1wf3/esp32-s3/output/navigation-concepts/04-全长方屏配色与设备管理.png

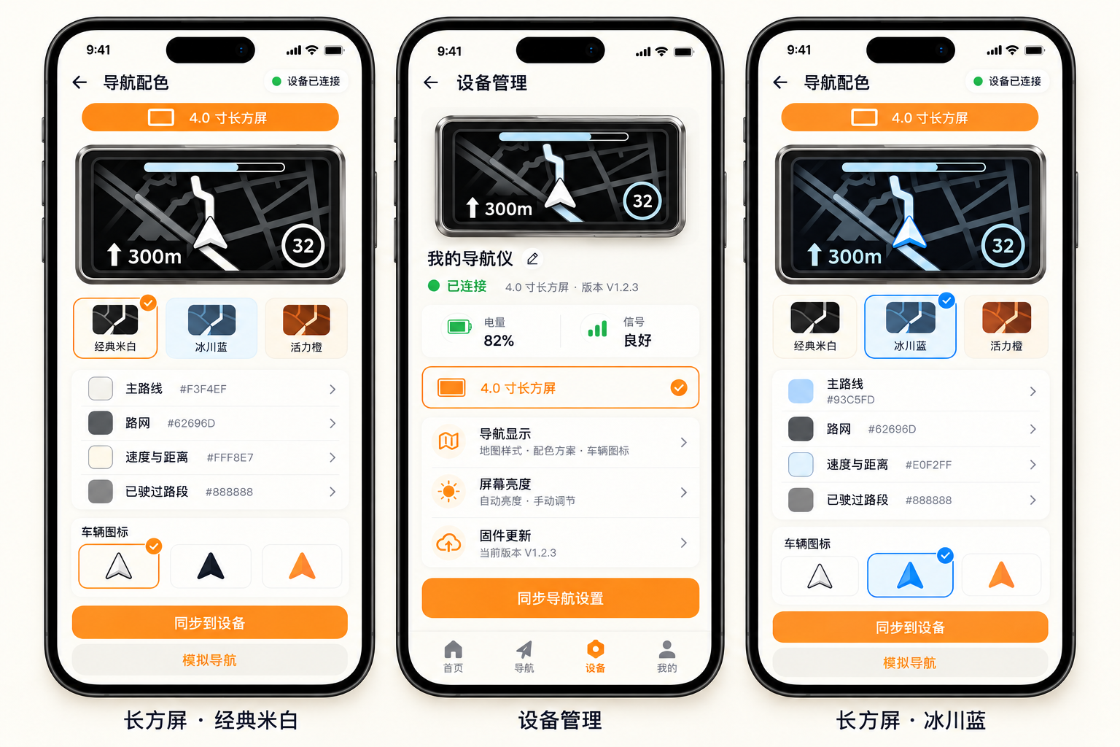
output/navigation-concepts/04-全长方屏配色与设备管理.png
