1wf3/esp32-s3/output/navigation-concepts/05-开机动画概念分镜.png

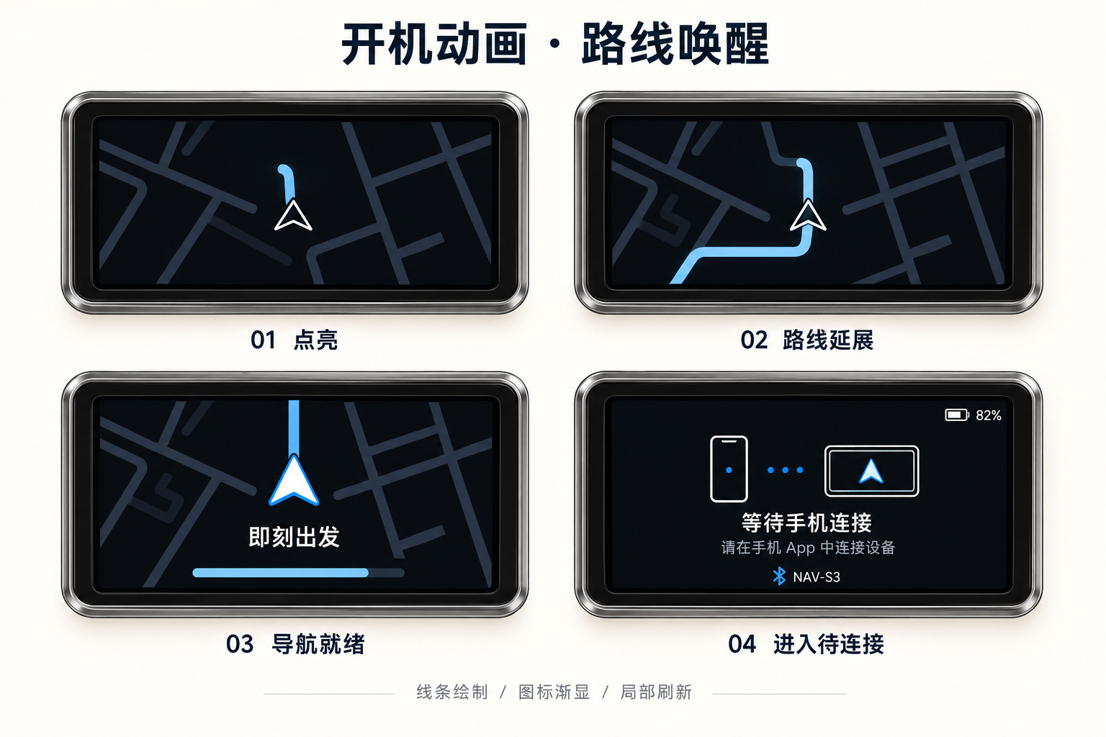
output/navigation-concepts/05-开机动画概念分镜.png
