1wf3/esp32-s3/output/carrier_v01/PCB全部连接表_当前J1J4位号.md

# PCB 全部连接表（当前位号，2026-10-20）

本表依据实物照片转录的排针顺序、用户当前原理图及 phone_ble_nav 固件整理。它是布线目标，不表示用户 PCB 已完成连通性或机械验收。

## 位号与方向

- 顶面视图：天线在上、USB 在下，两排 1 脚均在上。
- J1：左排 1×22 排母，原称 J1A。
- J4：右排 1×22 排母，原称 J1B。
- J2：屏幕 2×5 接口；J3：GPS XH4 接口；JP1：两针电源跳帽。
- 电阻两端以 PCB 焊盘的实际网络名区分，不用画面左右方向判断。移动或旋转元件不会改变焊盘网络。

## 当前采用的布局（2026-10-20 17:46 截图）

用户选择保持此布局：J1 是中部的 22 针排母，J4 是最右侧 22 针排母；J3 在 J1 左上方、J2 在 J1 左下方、JP1 在 J1 左上侧；多数屏幕信号电阻位于 J1 与 J2 之间。
该布局下，先把 GPIO 端焊盘短接到 J1 对应针脚，再把 LCD 端焊盘通过左侧短通道接到 J2。不能沿用更早截图中“某个元件在右侧”的位置描述判断网络。
排母整体已经移动，之前 1 脚坐标 (60,-70)/(1060,-70) 不再可直接套用。两排中心距、1～22针距、实际天线投影及底板开窗/禁铜需按新位置复核；旧板框顶部与天线外伸的结论未验证。

## 信号：每条都分成电阻前后两个网络

| 功能 | 开发板端 | 第一网络 | 电阻 | 第二网络 | 外设端 |
|---|---|---|---|---|---|
| 屏幕时钟 | J1.18 | GPIO12 | R1 33Ω | LCD_SCK | J2.3 |
| 屏幕写数据 | J1.17 | GPIO11 | R2 33Ω | LCD_MOSI | J2.5 |
| 屏幕片选 | J1.16 | GPIO10 | R3 0Ω | LCD_CS | J2.7 |
| 屏幕数据/命令 | J1.15 | GPIO9 | R4 0Ω | LCD_DC | J2.6 |
| 屏幕复位 | J1.20 | GPIO14 | R5 0Ω | LCD_RST | J2.8 |
| 屏幕读数据 | J1.8 | GPIO15 | R6 0Ω | LCD_MISO | J2.10 |
| GPS 向开发板输出数据 | J1.10 | GPIO17 | R8 1kΩ | GPS_TX | J3.3 |

例：J1.18 与 R1 的 GPIO12 焊盘同网；R1 另一焊盘与 J2.3 同属 LCD_SCK。不要用导线跨过电阻把两个网络短接。

## 电源与背光

1. DEV_3V3：J1.1、J1.2、JP1.1 全部相连。
2. 3V3_PERIPH：JP1.2、J2.2、J3.1、R7 的 3V3_PERIPH 焊盘、C1～C6 的电源端全部相连。
3. LCD_LED：R7 的 LCD_LED 焊盘接 J2.9。R7=0Ω，仅作连接/隔离，不是裸 LED 的限流电阻。
4. JP1 使用插拔跳帽接通两针。PCB 上不应另用铜线绕过 JP1 连接 DEV_3V3 和 3V3_PERIPH。
5. USB 电源仍从现有开发板 USB 进入。J1.21（5V）不接，不接车辆高压电源。

## 公共地

以下全部属于 GND：

- J1.22。
- J4.1、J4.21、J4.22。
- J2.1、J2.4。
- J3.2。
- C1、C2、C3、C4、C5、C6 的接地端。

建议保持底层 GND 尽量连续。顶层贴片电容的地焊盘可用附近接地过孔连接到底层 GND。布铜后检查孤岛和实际连接，不能仅凭可见铜皮认为所有地已接通。

## 六颗电容

全部是无极性陶瓷电容，一端接 3V3_PERIPH，另一端接 GND，按导入的焊盘网络连接。

| 位置 | 10µF | 100nF |
|---|---|---|
| JP1 外设供电侧 | C1 | C4 |
| 屏幕 J2 电源侧 | C2 | C5 |
| GPS J3 电源侧 | C3 | C6 |

## 留空针脚

- J1：3、4、5、6、7、9、11、12、13、14、19、21。
- J4：2～20。
- J3：4。GPS 的 RX/PPS 不接。
- 安装孔无电气网络，孔周围安装禁布区不走线、放铜或放器件。

## 按顺序布线

1. 缩短 R1 输出的 LCD_SCK 走线。当前沿板底绕行的线路建议改成穿过排母相邻焊盘间隙的短路径，以规则允许的通道为准。不要接触其他焊盘，也不要降低安全间距强行通过。
2. 布 R2/MOSI，再布 CS、DC、RST、MISO 和 GPS。
3. 布电源与背光支路，再完成地连接与 GND 铺铜。
4. 信号线默认 10mil；电源主干初始采用 32mil。靠近小焊盘时按间距规则适当收窄，不能挤到旁边焊盘。
5. 优先顶层短信号线，保留底层连续地。若通道实在不足，可从顶层 SMD 焊盘短引出后用金属化过孔换到底层；J2/J1/J4 的通孔焊盘可从底层连接。只在屏幕上切换图层不会产生电气连接。
6. 每根线从正确网络的焊盘开始，到同网络目标焊盘结束。蓝色飞线是连通提示，不是必须照着走的物理路径。
7. 最终运行 PCB 的设计→检查DRC；区分原理图DRC结果。检查未连接、短路、间距、板边、安装禁布区，并在铺铜后再次核对。

## 接外设线束

J2/J3 是本底板定义的针序，连接现有屏幕和 GPS 模块时必须按各自实物丝印逐信号对应，不假设原模块针序与底板相同。

仍待核对：排母实际孔径/高度/插接、首次至末次针距、USB 插头空间、GPS/屏幕线束和总电流。未完成实际投板或硬件验收。
