1wf3/esp32-s3/output/carrier_v01/嘉立创绘制说明.md

# 导航转接底板 V0.1：嘉立创 EDA 绘制说明

设计日期：2026-10-19。用户选择保留现有开发板，制作插接底板。已生成电气原理图与位置示意，尚无实际 EDA 工程、ERC/DRC 或可生产 Gerber。开发板排针封装、屏幕原插座顺序与安装孔距需要实测，不能按图中比例猜。

## 一、设计选择

充电宝 → 开发板原 USB 口 → 开发板原稳压器 → DEV_3V3 → JP1 → +3V3_PERIPH。保持与现有面包板一致的 3.3 V 供电及 GPIO 分配。底板不新增 USB、电源芯片、车载电源、锂电充电、电量、鸣笛或亮度电路。GPS 沿用现成 ATGM336H 板及原天线，底板不做射频线路。

JP1 是两针短路帽，只隔离屏幕/GPS外设电源。拔下 JP1 不会关闭开发板；要完全关机需断开 USB。不要给 TP1/TP2 或外设网络同时灌入第二路电源。R7 为 0Ω 跳线，不承担背光恒流/限流，限于目前已点亮的现成屏幕背板输入。

屏幕使用已验证的 ILI9488 兼容初始化，这不等于已确定液晶驱动芯片型号。当前固件 40 MHz SPI；外设逻辑和电源均为 3.3 V。GPIO12=SCK、11=SDI、10=CS、9=D/C、14=RESET、15=SDO；GPS TX→R8→GPIO17，GPS RX/PPS 不接。触摸 GPIO4/5/6/7 仅预留，当前固件不启用。

## 二、在嘉立创 EDA 画原理图

1. 先建 J1A/J1B 两条开发板排母：实测 N（每排针数）、P（针间距）、D（两排中心距）后，按元件面实际顺序逐脚编号。图中 U1 为功能表示，不能把 GPIO 编号直接当排母焊盘编号，也不能套官方 DevKitC-1 封装假定兼容。
2. 复制“接口逐针网络表.csv”中的网络标签；ESP32 端 GPIO 名与实物的排针脚号需要你逐项对应。每一颗串联电阻两侧是不同网络，不能把两端用同一标签短接。
3. J2 用防呆 2×5/2.54 mm 简牛，符号脚号与所选 PCB 焊盘对应。针序是本底板定义，不是现有屏幕的原排针序。排线另一端按屏幕丝印配线；若要直接插屏幕，需额外按原接口实测制作小转接头。
4. J3 用 XH-4/2.50 mm，1=3.3 V、2=GND、3=GPS TX、4=NC。此针序同样为底板定义，GPS 原模块接口不一定相同。J3-4 加未连接标记，线束对应孔留空。
5. 串联电阻：R1/R2=33Ω；R3/R4/R5/R6/R7=0Ω；R8=1kΩ。先按图安装，R1/R2可备22Ω/0Ω用于波形或兼容性调试；阻值不是所有线长下的保证。
6. C1/C3/C5=10µF，C2/C4/C6=100nF，分别跨接 +3V3_PERIPH 与 GND。C1/C2靠JP1，C3/C4靠J2，C5/C6靠J3。0805仅是本方案建议封装；10µF/≥10V/X7R需要核对直流偏压后的有效电容。
7. J4 为可选 XH-6：1=3.3V、2=GND、3=GPIO4/SDA、4=GPIO5/SCL、5=GPIO6/INT、6=GPIO7/RST。R9/R10为4.7k上拉，分别从GPIO4/5到3.3V，C7为J4供电去耦。J4、R9/R10、C7默认不装；模块已有上拉时不重复装。
8. 测试点：TP1=DEV_3V3，TP2=+3V3_PERIPH，TP3=GND，TP4=GPIO17（R8的ESP32侧）。不用的开发板引脚标NC；5V/VIN、EN/BOOT、USB19/20等保持原开发板电路，不另外并接。
9. ERC后再转PCB。若输入电源被ERC认为未驱动，使用工具相应的电源标识表达“由开发板输出”，不要为消除报错把不同电源网短接。

## 三、底板封装和布线

机械待测表：

| 项目 | 数值 | 怎么测 |
|---|---|---|
| 每排针数 N | 待测 | 左右分别计数，不假定20/22脚 |
| 排针脚间距 P | 待测 | 测多脚中心距离除以间隔数，避免单格误差 |
| 两排中心距 D | 待测 | 从同一端对应排针中心量到另一排中心 |
| 屏幕原接口针序/间距 | 待测 | 正反面丝印照片+厂家尺寸图+万用表 |
| 屏幕/开发板尺寸与安装孔距 | 待测 | 卡尺，注明元件面与孔中心 |
| 排母高度/USB空间 | 待测 | 检查开发板背面元件不顶到底板 |
| LDO型号及额定/热能力 | 待测 | 板上器件丝印、实际板资料、负载测量 |

建议2层FR-4/1.6mm/1oz；本方案不是ESP32裸模块重设计。信号起步0.25mm、间距0.25mm，3.3V主干起步0.8mm，按负载和可制造性复核。底层尽量完整GND，不在SPI下方跨地分割。R1/R2尽量靠ESP32源端，R6靠SDO输出端J2。PCB上MCU到J2目标≤30mm，排线尽量≤50mm；这些是布线目标，不是40MHz必定稳定的承诺。

ESP32天线端优先伸出底板边缘；天线下方不要铺铜、走线、放金属或电池，净空按对应模块手册。GPS原天线朝天，远离时钟线和屏幕；保留原射频线，不随意换有源/无源天线。底板边框、孔距随实物与外壳确定，本图不给未经测量的80×60等尺寸。四个M3孔可先按Ø3.2mm非金属化孔考虑，但孔距、螺母净空和螺柱高度都要复核。打印1:1纸样套实物后再下单。

## 四、电源预算是定版条件

这是无源连接底板，外设电流全部经过现有开发板LDO。应核对 I_LDO总=I_ESP32板+I_LCD含背光+I_GPS+I_可选触摸，并用实际板电路确认额定、热余量与启动瞬态。不能从“USB 5V 1A”推导3.3V端也能输出1A。

先保持现有供电路径：USB只接开发板，外设只接3.3V。如果LDO过热、3.3V跌落或超出规格，暂不投板，改为独立稳压并进行电源隔离的新版本；不要把额外稳压器直接并到开发板3V3输出。当前没有开发板稳压芯片型号，未虚构其可用输出电流。

焊接前断电；JP1拔下可区分开发板与外设负载。完成线束和电源通断检查后，先只给开发板上电测TP1，再断电插模块、合JP1测TP2。GPS RX/PPS不接，TX只能接GPIO17输入。依次检查显示、蓝牙、NMEA和室外搜星；便携安装应固定线束和模块，避免仅靠排母承重。

## 五、物料清单

完整见“物料清单_BOM.csv”。已有ESP32-S3、屏幕、GPS及天线复用。新购主要为两条排母、J2简牛与短线束、J3 XH-4线束、JP1短路帽、电阻8颗、电容6颗、PCB与安装件。可选触摸件不计入上述8颗电阻/6颗电容。测试点是PCB焊盘，不额外采购。连接器在嘉立创按规格找料，确认针距、脚号、方向、外形与孔径，不按本图选未经匹配的商城编号；没有声明价格或库存。

## 六、来源与状态

- 本地接线：software/phone_ble_nav/phone_ble_nav.ino；GNSS模块接线与测试.md；GNSS首次搜星诊断.md；大屏真实导航使用说明.md。仅采用其中当前仍有效的硬件接线，不沿用历史Wi-Fi独立导航方案。
- Espressif供电参考：https://docs.espressif.com/projects/esp-dev-kits/en/latest/esp32s3/esp32-s3-devkitc-1/user_guide_v1.0.html （官方板参考，不能证明你的克隆板封装或电流能力相同）
- Espressif天线/PCB布局：https://docs.espressif.com/projects/esp-hardware-design-guidelines/en/latest/esp32s3/pcb-layout-design.html （本方案的两层载板建议属于基于指南的工程推导，不等于官方完整设计）
- JST XH 官方规格：https://www.jst.com/wp-content/uploads/2025/06/eXH.pdf （针距2.50 mm；连接器和压接端子需同系列匹配）
- 中科微ATGM336H-5N：https://icofchina.com/daohang/danpin/2525.html （裸模块2.7~3.6V；你的成品转接板供电仍需实物核对）

本设计已在文档层核对接口脚号、BOM位号及固件GPIO；未接入嘉立创EDA，未跑ERC/DRC，未制作或上电测试新PCB。下一步需要开发板、屏幕、GPS正反面清晰照片和上述机械数据，才能冻结排母封装与板框。
