1wf3/esp32-s3/output/carrier_v01/开发板插座接线_按实物照片.md

# 开发板插座接线（2026-10-19 实物照片核对）

依据：IMG_2199.JPG 背面丝印、IMG_2196.JPG 元件面照片。尚未做万用表通断核对。

## 统一方向

元件面（有金属屏蔽罩、按键、USB 接口的一面）朝向自己，天线在上，USB 在下。
左排定义为 J1A，右排为 J1B。两排的 1 脚均在天线端，22 脚均在 USB 端。
背面照片左右相反，不可直接照搬背面照片的左右关系到 PCB 顶层。
这是本转接板对插座的编号约定；PCB 上必须核对所选封装的实际焊盘编号并正确旋转。

## 本次需要连接的引脚

| 插座针号 | 实物丝印 | 网络标签 | 去向 |
|---|---|---|---|
| J1A.1、J1A.2 | 3V3 | DEV_3V3 | JP1.1 |
| J1A.8 | 15 | GPIO15 | R6 MCU 侧 |
| J1A.10 | 17 | GPIO17 | R8 MCU 侧，另一端接 GPS_TX/J3.3 |
| J1A.15 | 9 | GPIO9 | R4 MCU 侧 |
| J1A.16 | 10 | GPIO10 | R3 MCU 侧 |
| J1A.17 | 11 | GPIO11 | R2 MCU 侧 |
| J1A.18 | 12 | GPIO12 | R1 MCU 侧 |
| J1A.20 | 14 | GPIO14 | R5 MCU 侧 |
| J1A.22 | GND | GND | 公共地 |
| J1B.1、J1B.21、J1B.22 | GND | GND | 公共地 |

JP1.2 使用 3V3_PERIPH。不要把 DEV_3V3 改成 3V3_PERIPH，否则会绕过跳帽。
J1A.21 是 5V，本版由开发板 USB 供电，转接板该脚不接。
GPIO17 是信号名称，不是插座第 17 脚；对应关系见表。
未使用的其余插座针脚最后添加非连接标识，不要接地。

## 操作顺序

1. 在 J1A、J1B 附近写明上述正面方向与 1 脚方向，普通文字仅作说明。
2. 从表内每个针脚端点画短导线，用网络标签工具放上完全相同的标签。普通文字不产生电气连接。
3. 先接 DEV_3V3 与 GND，再接 GPIO 信号。
4. R8 为 1kΩ：GPIO17—R8—GPS_TX—J3.3；J3.4 放非连接标识。
5. 在网络列表核对同名网络包含相应插座、JP1、电容与连接器端点；检查没有把电阻两端用相同标签短接。
6. 完成原理图检查后再转 PCB；两排插针中心距 D 已于 2026-10-20 根据用户提供数值与 IMG_2206.JPG 尺寸图确认为 25.40mm（1000mil）。这不是板宽或塑料座外沿间距。

## 已补充的机械尺寸（2026-10-20）

- 每排 22 针，相邻针距 2.54mm。
- 两排焊盘中心线间距 25.40mm。
- 同排第 1 针至第 22 针中心距离：21 × 2.54 = 53.34mm。
- 用户尺寸图中的开发板宽度为 27.94mm，不含天线突出部分的板体长度为 57.15mm；这些不是转接底板外形尺寸。
- 数据来自用户数值与所附尺寸图，未独立实测。底板的元件封装、焊盘孔径、实际插接方向、USB 插头空间与天线避让仍需核对。
- 定位以焊盘中心为准。元件属性中的 X/Y 是封装原点，只有两个封装的原点和旋转一致时，元件 X 坐标差才可直接作为排距。

当前电容编号按用户原理图：C1/C2/C3 = 10µF；C4/C5/C6 = 100nF。
三组对应电源入口 C1+C4、屏幕 C2+C5、GPS C3+C6；六颗均跨接 3V3_PERIPH 与 GND。
旧版资料包中电容位号安排不同，以此说明和当前 EDA 图为准。

机械尺寸、排母封装焊盘方向、电源负载与 ERC/DRC 尚未完成核验，当前不可直接投板。
