1wf3/esp32-s3/output/carrier_v01/主原理图预览.png

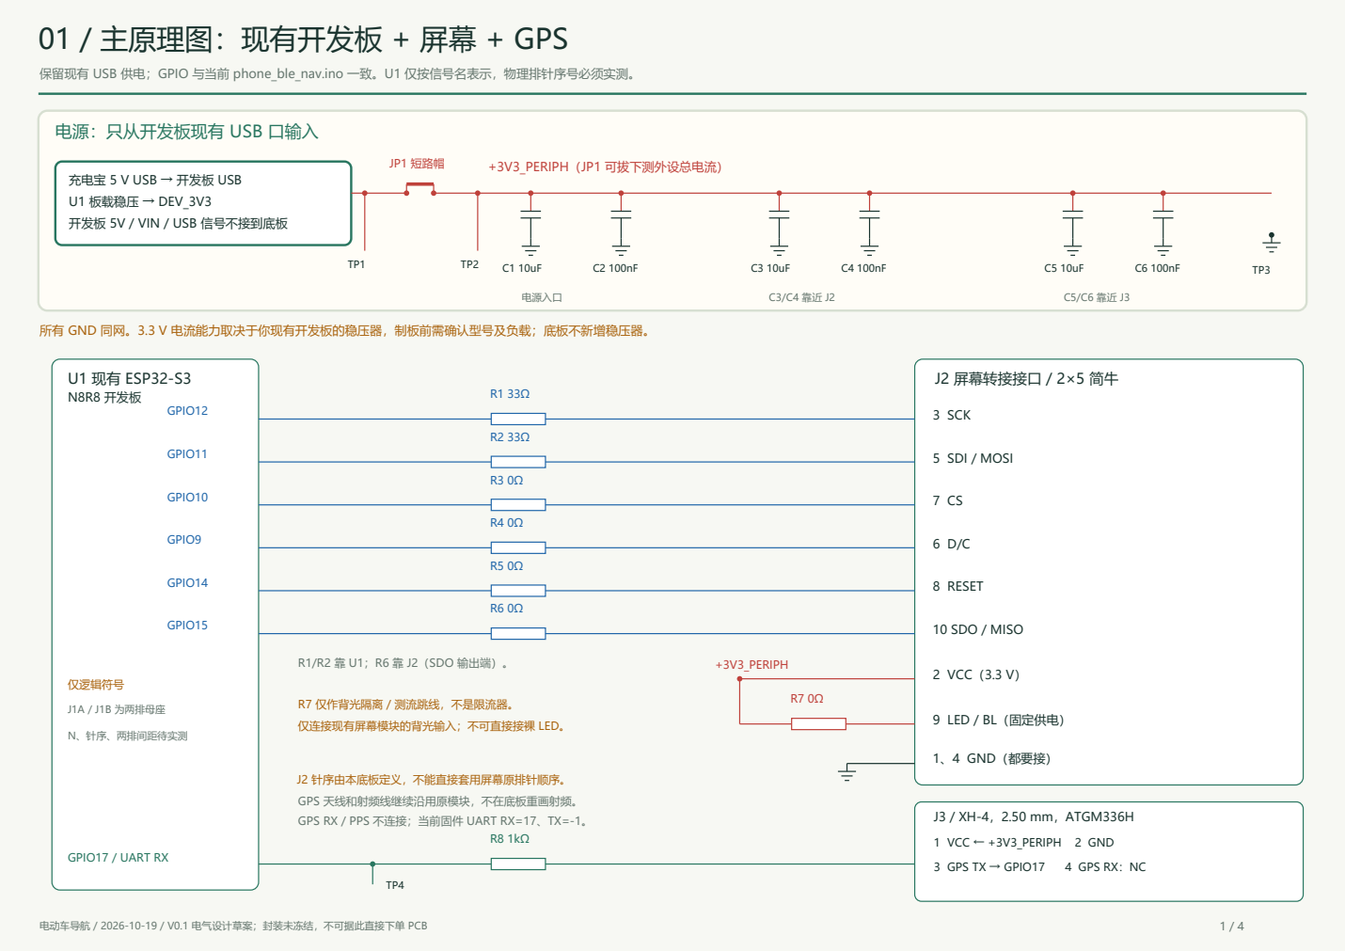
output/carrier_v01/主原理图预览.png
