1wf3/esp32-s3/output/carrier_v01/图纸预览_02.png

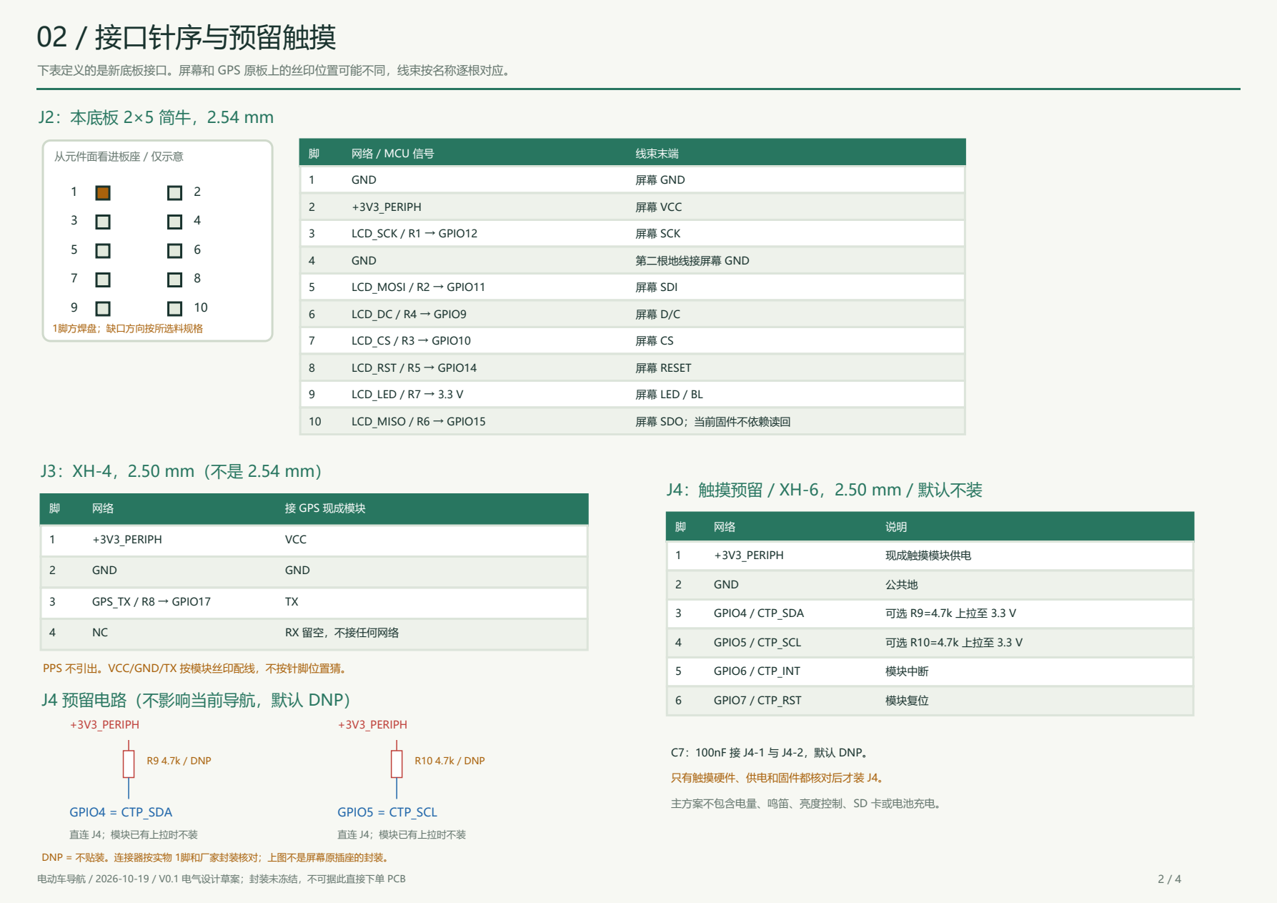
output/carrier_v01/图纸预览_02.png
