1wf3/esp32-s3/output/carrier_v01/背面引脚核对.png

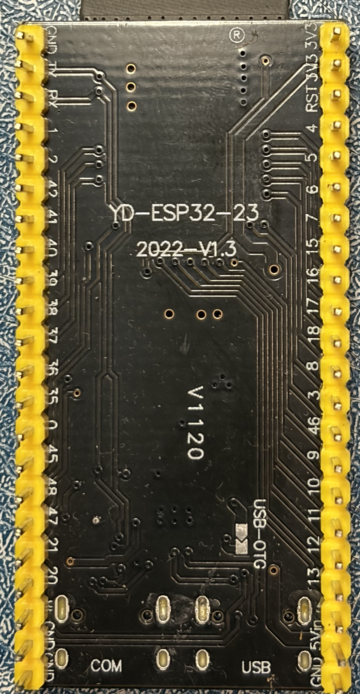
output/carrier_v01/背面引脚核对.png
