1wf3/esp32-s3/output/navigation-concepts/01-手机定位与导航.png

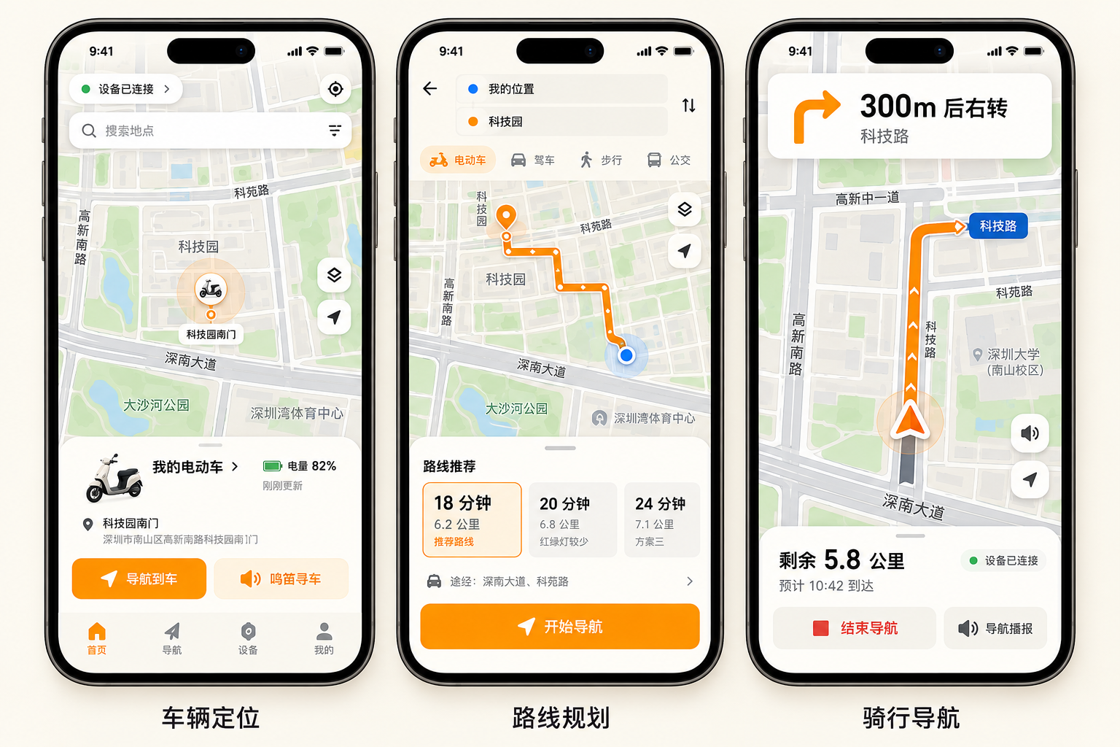
output/navigation-concepts/01-手机定位与导航.png
