1wf3/esp32-s3/output/navigation-concepts/02-配色与设备管理.png

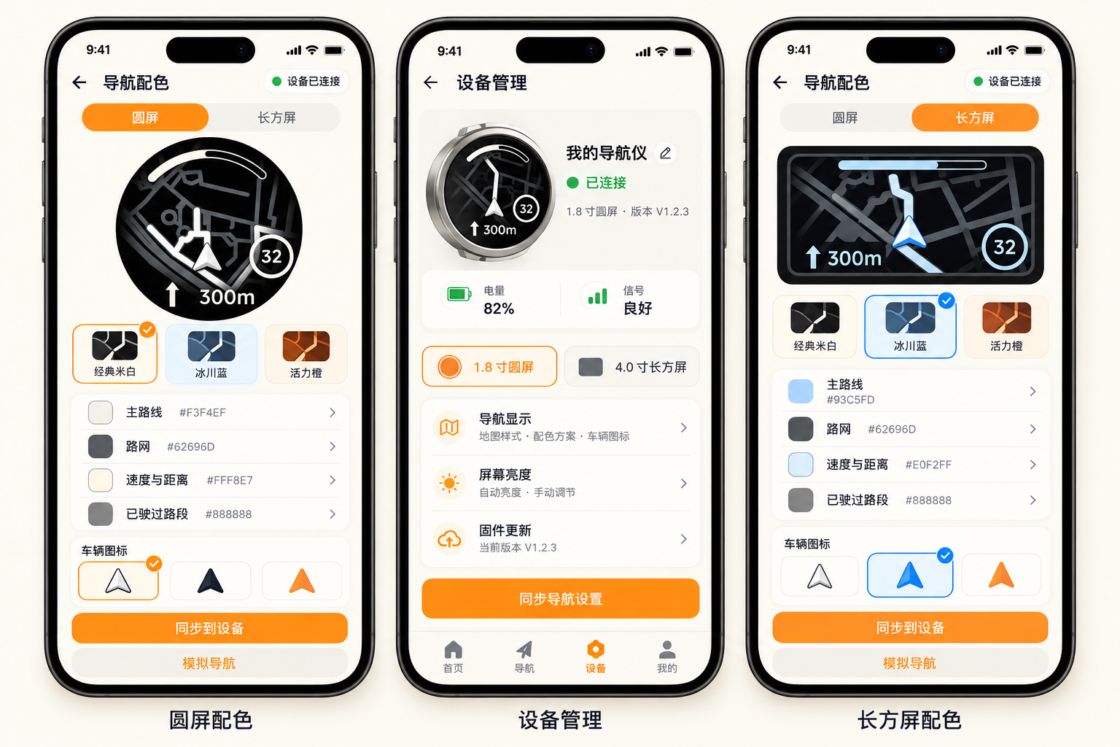
output/navigation-concepts/02-配色与设备管理.png
