1wf3/esp32-s3/output/navigation-concepts/03-圆屏与长方屏导航状态.png

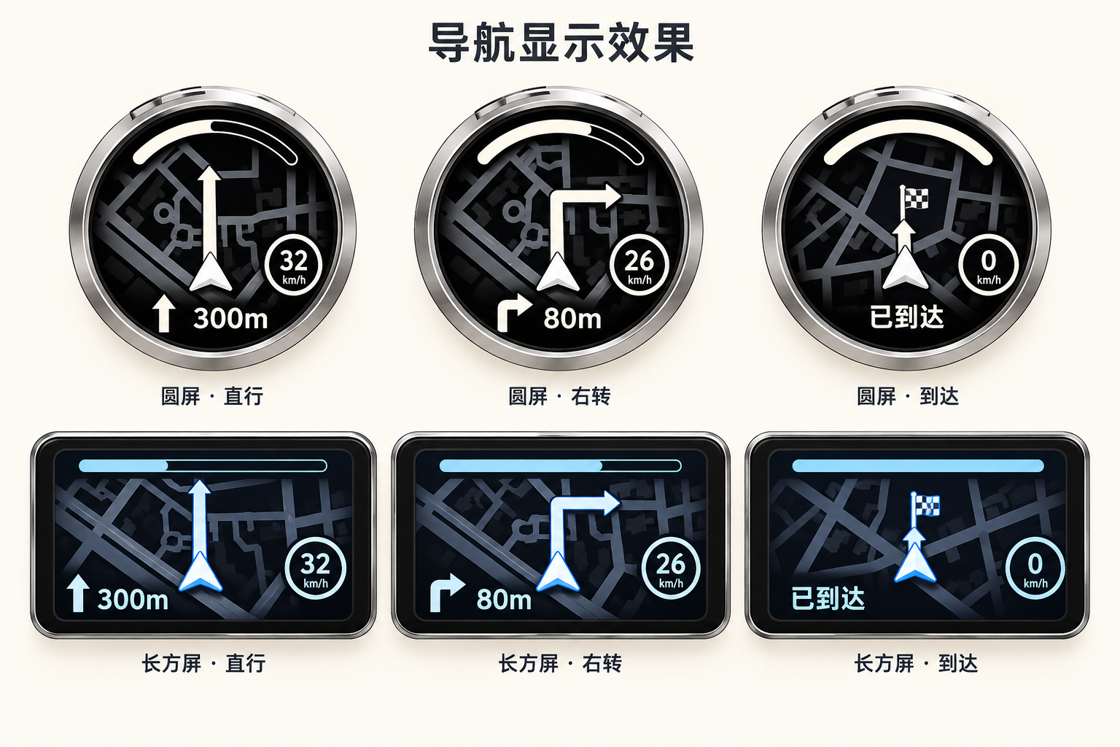
output/navigation-concepts/03-圆屏与长方屏导航状态.png
