1wf3/esp32-s3/output/navigation-concepts/06-等待手机连接.png

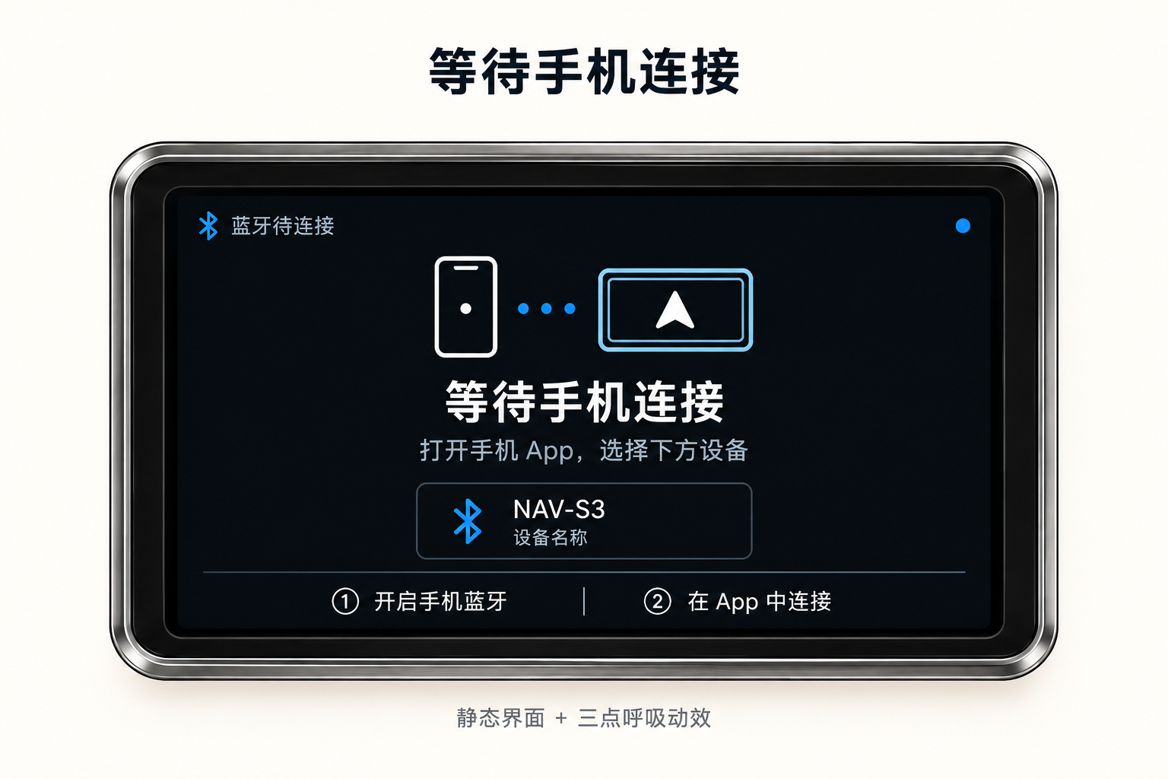
output/navigation-concepts/06-等待手机连接.png
