1wf3/esp32-s3/output/previews/map-scale-20261101/before.png

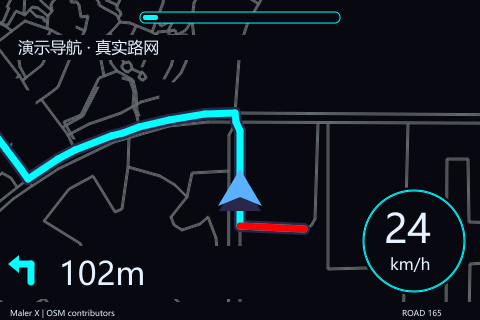
output/previews/map-scale-20261101/before.png
