1wf3/esp32-s3/output/previews/导航屏真实路网效果预览.png

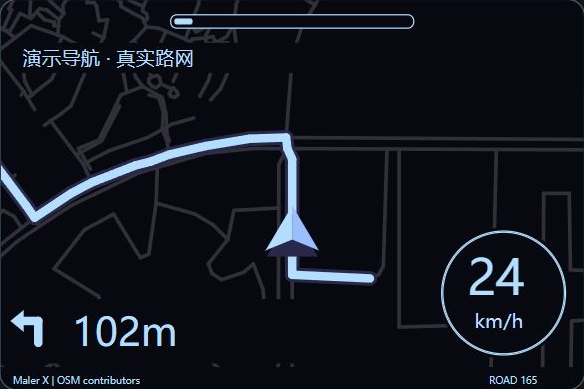
output/previews/导航屏真实路网效果预览.png
