1wf3/esp32-s3/output/previews/开机与手机连接预览.png

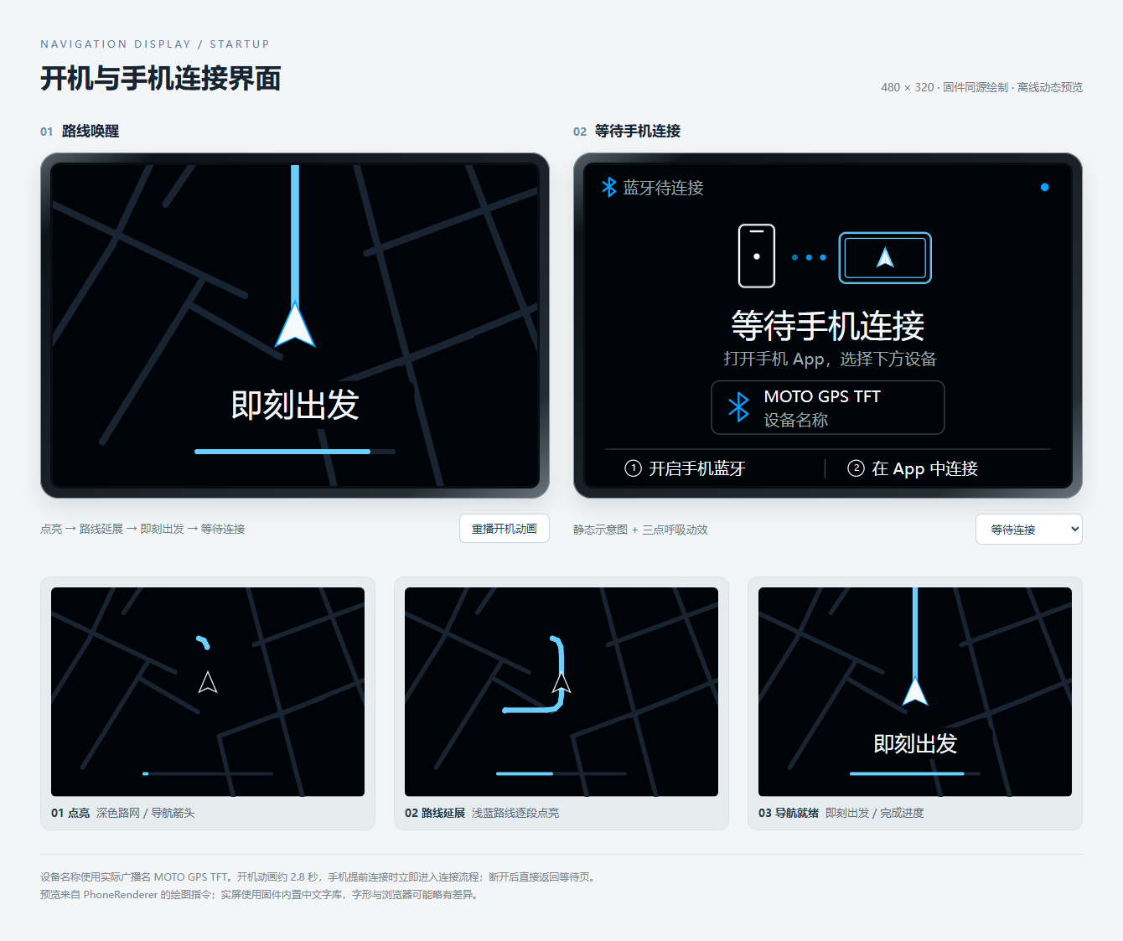
output/previews/开机与手机连接预览.png
