1wf3/esp32-s3/output/previews/开机与等待连接动画.gif

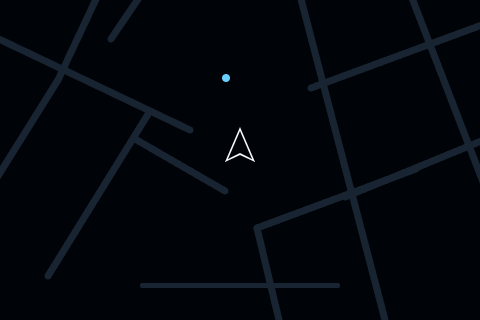
output/previews/开机与等待连接动画.gif
