1wf3/esp32-s3/output/previews/手机应用新版配色.png

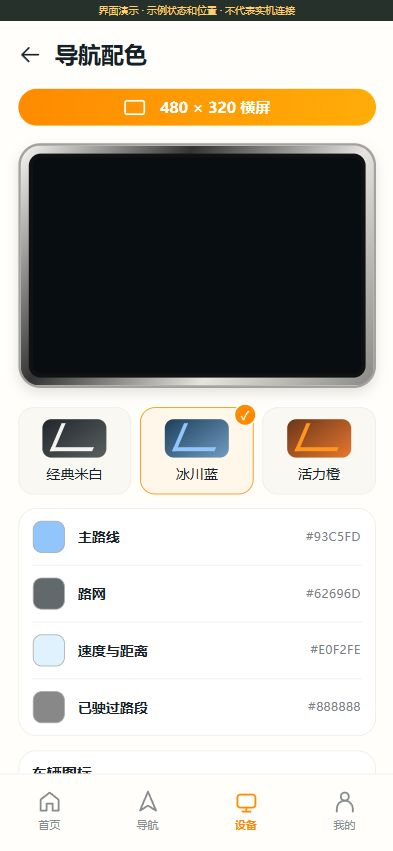
output/previews/手机应用新版配色.png
