1wf3/esp32-s3/output/previews/等待手机连接.png

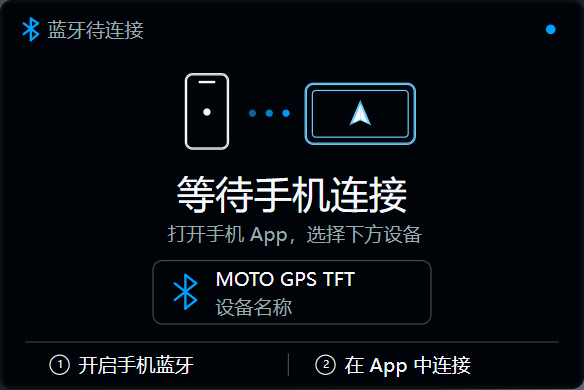
output/previews/等待手机连接.png
