1wf3/esp32-s3/output/carrier_v01/物料清单_BOM.csv

位号 | 规格 / 搜索关键词 | 数量 | 状态 | 备注
U1 | 现有 ESP32-S3 N8R8 开发板 | 1 | 已有 | 实物型号 / 稳压器 / 引脚排列待核对
LCD1 | 现有 4.0 寸 480×320 SPI 屏模块 | 1 | 已有 | 已用 ILI9488 兼容初始化；不据此确认屏芯片型号
GPS1 | 现有 ATGM336H-5N-31 模块及原天线 | 1 | 已有 | 保持现有 3.3 V 接法
J1A,J1B | 1×N 直插排母，针距按实物 | 2 | 必装 / 待测 | N、两排间距及插入高度均需实测
J2 | 2×5 / 2.54 mm 防呆简牛，直插 | 1 | 必装 | 按所购料规格匹配缺口、孔径和外形
J2线束 | 10 芯配套 IDC 母插 + 短排线 | 1套 | 必需 | 另一端按屏幕丝印配线；不假定能直接插原接口
J3 | XH-4，2.50 mm 直插座 | 1 | 必装 | 配同系列外壳与端子；不能套 2.54 mm 封装
J3线束 | XH-4 配套壳 / 端子 / 三根工作导线 | 1套 | 必需 | 1=3.3 V，2=GND，3=GPS TX，4空
JP1 | 1×2 / 2.54 mm 排针 + 短路帽 | 1套 | 必装 | 外设 3.3 V 隔离，选额定电流满足实测负载的料
R1,R2 | 33 Ω，0805，1% | 2 | 必装 | SPI SCK / MOSI 源端串联；可备 22 / 0 Ω 调试
R3,R4,R5,R6,R7 | 0 Ω，0805 | 5 | 必装 | R7 不是背光限流器，仅用于现有模块输入
R8 | 1 kΩ，0805，1% | 1 | 必装 | GPS TX 到 GPIO17 串联
C1,C3,C5 | 10 µF / ≥10 V / X7R，0805 | 3 | 必装 | 查 3.3 V 直流偏压有效容量；模块入口去耦
C2,C4,C6 | 100 nF / ≥16 V / X7R，0805 | 3 | 必装 | 靠近对应模块接口电源脚
TP1~TP4 | 直径约 1.5 mm 测试焊盘 | 4 | PCB图形 | DEV_3V3、PERIPH_3V3、GND、GPIO17
H1~H4 | M3 螺柱、螺钉、绝缘垫圈 | 4套 | 按外壳选 | 长度取决于开发板与屏幕底部元件高度
PCB | 2层 FR-4 / 1.6 mm / 1 oz | 1 | 待封装定版 | 板框、孔距、排母间距未测前不要下单
USB线 / 电源 | 已有充电宝及短 USB 数据 / 供电线 | 1套 | 优先复用 | 接开发板原 USB；确认充电宝不会自动断电
J4 | XH-6，2.50 mm 直插座及配套线束 | 1套 | 可选 / DNP | 仅触摸预留，当前导航固件未启用触摸
R9,R10 | 4.7 kΩ / 0805 / 1% | 2 | 可选 / DNP | I2C 上拉；模块已有上拉时不重复装
C7 | 100 nF / ≥16 V / X7R，0805 | 1 | 可选 / DNP | J4 电源去耦
