1wf3/esp32-s3/output/carrier_v01/实物装配与线束接线_2026-10-27.md

# 转接板实物装配与线束接线

照片依据：用户提供的 `D:/Downloads/IMG_2294.JPG`。本文方向始终为元件面朝向观察者，与这张照片一致：两排长排母在左/中部，J2、J3、JP1 在右侧。

连接依据：此前工程检查的焊盘网络表，并与工作区后期备份 `电动车转接板10.19_backup/电动车转接板10.19_2026-10-20-23-09.epro2` 中的 J1/J4/J2/J3/JP1 焊盘网络及方向复核一致。尚未用实物万用表验证，也未确认照片上的每颗元件阻值和焊点质量。

## 开发板插入方向

- 全部断电操作，屏幕与 GPS 暂不接，JP1 暂不插跳帽。
- 照片最左侧长排母为 J4，靠右、紧邻电阻和外设接口的长排母为 J1。
- ESP32 开发板的元件面、金属屏蔽罩朝外，排针朝向转接板。
- USB 接口朝照片上边，黑色 PCB 天线朝照片下边。
- 开发板印有两个 3V3 的一排对应右侧 J1；3V3 两针位于照片下端，对应 J1.1/J1.2。
- 开发板含 GND、TX、RX 的另一排对应左侧 J4；天线端 GND 对应照片下端 J4.1。
- 两排各 22 针全部对准后，均匀压入，不能错开一个孔或只有一排插入。

本方向相当于此前“天线上、USB 下”的设计图旋转 180°；不能混用两种画面方向。

## J2 屏幕接口

按照片元件面俯视，J2 是右上方黑色 2×5 牛角座；其缺口朝照片上边。针号从左至右：

```text
                  缺口朝照片上方
上排：        9     7     5     3     1
下排：       10     8     6     4     2
```

这是板上插针视图，不是配套线束插头从线端看的视图；后者可能镜像。J2.1 对应 PCB 方形焊盘，并可断电测其与 GND 导通确认；与 J2.2 的 3V3 不可互换。针号排布依据工程，首次接线仍以方形焊盘/1脚标记及导通测量确认。

| J2 针号 | 网络 | 接现有屏幕上的丝印 |
|---|---|---|
| 1 | GND | GND |
| 2 | 3V3_PERIPH | VCC（沿用此前验证的 3.3V 供电） |
| 3 | LCD_SCK | SCK / CLK |
| 4 | GND | 第二个 GND；屏幕只有一个 GND 时可留作备用 |
| 5 | LCD_MOSI | SDI / MOSI / DIN |
| 6 | LCD_DC | D/C / DC / RS |
| 7 | LCD_CS | CS |
| 8 | LCD_RST | RESET / RST |
| 9 | LCD_LED | LED / BL（经板上 R7 从 3.3V 供电） |
| 10 | LCD_MISO | SDO / MISO / DOUT |

必须按屏幕实际丝印接信号，不能假定屏幕原插座针序与 J2 相同，不能把十芯排线不经核对就直接对插。VCC 与 LED 是屏幕的不同供电脚，不应因已有 VCC 而漏接 LED。

当前转接板只接显示功能；CTP_SDA/CTP_SCL/CTP_INT/CTP_RST、SD 卡及 NC 等额外引脚保留不接，不能随便接到 J2 空位。此说明不会为当前板增加触摸或 SD 功能。

## J3 GPS 接口

保持照片方向，J3 是右下方白色 4 针 XH 座。沿照片从上到下：

| J3 针号 | 照片位置 | 接 GPS 模块丝印 |
|---|---|---|
| 1 | 最上端，靠近 C3/C6 | VCC / 3V3 |
| 2 | 第二针 | GND |
| 3 | 第三针 | TX / TXD；板内经 R8 到 ESP32 GPIO17 |
| 4 | 最下端，靠近 JP1 | 未连接，线束该线留空并绝缘 |

GPS 的 RX/RXD、PPS 不接。GPS TX 不能接到开发板 USB 串口的 TX/RX。保留原天线射频线，陶瓷面朝天。

配套 XH 线束的颜色不能作为针号证据，需从板上 J3.1/J3.2 分别核对电源、地，确定每根线的去向。板端插针视角与线束从背面看的方向可能镜像。

## 上电顺序

1. 断开全部电源、开发板及外设，JP1 跳帽拔下。清理可疑焊接残留并检查焊桥，尤其照片电阻密集区域。
2. 万用表测 DEV_3V3 对 GND、3V3_PERIPH 对 GND 是否有持续近零欧短路；电容充电造成短暂蜂鸣不等于持续短路。
3. 按上述方向只插 ESP32，JP1 保持断开，接此前验证过的 USB 口供电，确认开发板正常。
4. 断电，给 JP1 两针插上 2.54mm 跳帽，仍不接外设；再次 USB 供电，测 J3.1 对 J3.2、J2.2 对 J2.1 电压，应为约 3.3V。
5. 断电接屏幕，检查 VCC/GND 与所有信号对应后再上电，先测试显示。
6. 再断电接 GPS，检查 VCC/GND/TX 后上电，测试串口与定位。

JP1 照片中未见跳帽，外设电源需要该跳帽接通；不需要另焊导线绕过 JP1。供电沿用 ESP32 USB，不把车辆高压电源接入这块板。

照片只能帮助判断方向和检查位置，无法证明焊点没有短路。若拿不准屏幕/GPS 的实际引脚，先提供其接线端丝印清晰照片再确定线束，避免盲接电源。
