1wf3/esp32-s3/docs/guides/手机蓝牙导航使用说明.md

# 手机蓝牙导航：安卓实机联调

当前路线是手机定位、选择目的地和规划路线，通过蓝牙把导航数据发给 ESP32-S3 大屏。不需要开发板上的 GPS 模块，也不需要给开发板连接手机热点。大屏当前运行的是 `software/phone_ble_nav/` 固件。

## 已准备

- 原生安卓测试应用：`software/android_nav/output/nav-screen-android-test.apk`，Android 8.0 及以上。
- 电脑导航网关：`software/phone_gateway/backend/`。高德 Key 保存在该目录的本地 `.env`，不要分享此文件。
- 开发板蓝牙广播名称：`MOTO GPS TFT`。
- 2026-10-05：开发板与电脑 BLE 联调通过；真实高德地点搜索与路线规划接口验证成功。公开济南测试起终点返回三条驾车路线，第一条约 1.61km、289 秒、36 个路线点。测试没有使用你的真实位置。
- 安卓协议与导航计算检查通过，113 项。Redmi Note 13 Pro（Android 16 / API 36）已成功安装并运行，精确定位、附近设备和通知权限已允许。
- 手机与开发板实际完成加密配对和两阶段 Ready 握手，串口持续得到 `BLE=1 ENC=1 READY=1`，未见协议错误；安卓前台定位和蓝牙服务已运行。
- 此前已确认手机真实导航快照到达开发板；室外移动、实际转向和锁屏稳定性仍需实机验证。2026-10-07 未检测到手机 USB 连接，本次使用公开演示导航数据验证显示。

原生测试应用的界面比 HTML 演示简单，优先验证定位、搜索、路线和 BLE。安卓路网版已接入周边真实 OSM / Protomaps 矢量地图；音乐控制尚未加入。测试使用驾车路线，电动车骑行规则尚未适配。

## 手机通过 USB 连接电脑

1. 开启手机开发者选项和 USB 调试，用支持数据传输的数据线连接电脑，并允许电脑调试。
2. 在项目目录运行：

```powershell
& '.\software\android_nav\install_phone_test.ps1'
```

脚本只在检测到一个已授权安卓设备时继续，安装测试 APK、打开应用，并设置本次 USB 连接的端口转发。启动应用时会自动填写并保存 `http://127.0.0.1:8787/` 网关地址。不会自动授予定位等权限。

红米若返回 `INSTALL_FAILED_USER_RESTRICTED`，请在手机允许本次安装，并检查开发者选项中的“USB 安装”。测试包也可从手机 `Download/nav-screen-android-test.apk` 打开安装。2026-10-05 已经通过 USB 正常安装成功。

## 手机应用操作

1. 开启手机蓝牙和位置信息。
2. 打开“导航屏助手（测试版）”，点击“开启会话 / 授予权限”，允许精确定位和附近设备权限，按需要允许通知。
3. 点击“扫描蓝牙设备”，选择 `MOTO GPS TFT`，按系统提示配对。
4. 导航服务地址填写 `http://127.0.0.1:8787/`，点击“保存并测试网关”。这是 USB 转发模式下手机访问电脑网关的地址。
5. 在室外开阔处等待有效 GPS 定位，搜索目的地、选择地点，再选择一条路线开始导航。
6. 查看大屏路线、速度、转向距离和剩余距离。定位过期或精度不足时会停止更新有效指引，不会用模拟位置替代。
7. 用“结束导航”停止指引，用“关闭会话”停止定位与蓝牙服务。

蓝牙配对可以在室内测试；真实路线起点需要有效手机定位。新调试包同时请求手机 GPS、融合与网络定位，并显示来源、精度和更新年龄；仅使用精度 ≤50 米且 15 秒内的新鲜位置，不以旧位置或模拟位置代替定位。目的地输入会自动保存在应用中。锁屏后的定位和蓝牙稳定性要在这台红米上单独验证。

## 重启电脑后的网关启动

在 `software/phone_gateway/backend` 目录运行：

```powershell
node --env-file=.env src/server.js
```

网关监听电脑的 `127.0.0.1:8787`。USB 拔掉或手机重启后，需要再次运行安装脚本或 ADB 端口转发；正常外出使用前需将网关部署到可访问的 HTTPS 服务。

HTML 前台演示的使用方法另见 `手机导航实机调试说明.md`。原来的独立 GPS、热点和开发板直连高德方案保留作历史参考。

2026-10-05 定位改进包已编译并验证签名（SHA256 `DE87F431C28FB9EB0659A54B9B56F8B9736FF506B1E27655F81CAD67EE25C1DD`）。该包已通过 ADB 更新安装到红米手机。自动恢复目的地及打开应用的组合命令曾被自动审批拦截。用户随后已开启会话、连接屏幕并开始导航；已确认定位与导航数据持续同步。

2026-10-05 开发板路线切换修复已烧录：缓存新几何，等匹配导航快照到达再切换。手机自动重连后连续采样路线有效，几何/快照版本一致，未见协议错误。当前用户在宿舍，静止且有偏航标志；下一步需到室外道路旁验证实际位置匹配、转向距离和移动更新。当前网关仍通过 USB 转发访问电脑，外出时不可直接拔线后继续依赖该地址。

2026-10-07 显示更新：480×320 全屏深色地图、灰色道路、浅蓝主路线与位置箭头、顶部进度、左下转向距离、右下圆形速度表。与参考图采用相似信息布局，数据位置不人工重画。定位过期和偏航时保留提示并停止有效转向显示。

显示预览见 `output/previews/导航屏真实路网效果预览.html`（自包含文件）及 `output/previews/导航屏真实路网效果预览.png`。预览使用已保存的济南真实 Protomaps / OSM 矢量瓦片，裁剪后 165 段道路；导航位置、速度和进度是公开演示数据，不代表用户当前所在地。

新固件已烧录并校验：SHA256 `A2EE7C2D61B0F93D0DE7B08A6D4A49CAA4416A0DD1A74F3A1596452A9896BC0B`。配套 APK SHA256 `BF47E53217E9C44FFF9CD22AF7C821A4FD9E61529204481EE921ADED39DCA3C1`，位于 `software/android_nav/output/nav-screen-android-test.apk`；随后红米已通过 USB 连接并成功安装本次 APK，网关和 USB 转发已恢复。该包扩大底图裁剪范围至中心附近 1000×1000 米，覆盖全屏地图旋转和 100 米刷新间隔；超出路网容量会提示错误，不按主路优先丢弃小路。OSM 路网完整性取决于地图源。

本套安卓与固件采用扩展的 MapScene 容量（192 段道路、1536 个道路点、16 KiB 消息上限）。旧上游设备仍使用原容量，需使用本套匹配固件。显示缩放固定为 0.8 像素/米，地图随当前路线视图原点和航向平移旋转。

2026-10-07 最新手机联调：真实导航中开发板收到 192 段周边路网，MAP=1、ROUTE=1、FLAGS=147、加密和 Ready 均有效，无协议错误。预览图使用济南公开数据并标记演示，实机使用手机当前位置获取的真实瓦片。电脑网关会话已重启，手机网关地址为 http://127.0.0.1:8787/，USB 转发 tcp:8787 有效。

2026-10-07 锁屏初测：前台服务、加密 BLE 和路网保持运行；室内融合/网络定位停止交付，GPS 无有效样本，15 秒后屏幕停止有效位置/转向显示。锁屏定位稳定性尚未通过，需要到开阔处取得真实 GPS 后复测；不延长位置有效期或用旧坐标冒充新位置。

解锁恢复已验证：用户未重启导航，系统恢复 Awake 后 BLE/ENC/READY 保持有效，NAV 计数持续增加，FLAGS 从 5 恢复为 155、ROUTE=1、MAP=1、MAP_ROADS=192，几何与快照版本一致。偏航标志仍存在，当前静止；下一步需在开阔窗边或室外取得卫星 GPS，并保留当前 USB 网关连接后再次进行锁屏测试。

2026-10-07 搜星诊断版 APK 已编译、签名校验并更新安装，SHA256 `2ACCB84FC70E9F847844F9EEC38FF8E123CD3A5F285AC2CCBFC18723CAFB639F`。开启会话后可查看可见卫星数、参与最近定位的卫星数、卫星状态年龄以及是否收到 15 秒内且精度不超过 50 米的 GPS 位置。诊断使用 Android GnssStatus，不包含经纬度；结束会话时注销监听。可见卫星数量不能单独证明定位有效，必须同时核对实际位置来源、精度与年龄。

搜星诊断实机验证完成：用户开启会话后 NavGnss 日志连续报告 satellites=45、后变为 18，used 始终为 0；导航前台服务运行，GPS 累计位置交付仍为 0。可见列表数量不等同于有效定位；目前需要在开阔位置观察 usedInFix 与新鲜 GPS 位置，再复测锁屏。日志仅包含卫星计数，不记录位置坐标。
