1wf3/esp32-s3/output/previews/手机导航实机调试.html

PHONE → BLE → DISPLAY

# 手机实机调试

先预览操作，再接入手机定位和现有大屏。

v0.1 / HTML

09:41浏览器调试页面

## 导航屏助手

手机选路线，屏幕看指引。

演示模式

先查看演示路线，体验导航流程。

演示使用济南公开测试路线；位置和速度为模拟数据。

搜索

济南 · 演示路线全程预览

演示底图 © OSM contributors (https://www.openstreetmap.org/copyright)

↑

-- m

等待路线

--剩余公里

--预计分钟

--当前 km/h

查看演示路线结束导航

路线在手机上选择；不需要外接 GPS 模块。

↱ 120 m

MOTO GPS TFT

ESP32-S3480 × 320未连接

连接真实蓝牙大屏断开连接

需要烧录本项目的 phone_ble_nav 固件，并在浏览器设备选择框中选择屏幕。

蓝牙链路未连接

导航协议等待握手

定位来源演示数据

浏览器环境检查中

工作模式

演示模式真实连接模式

切换模式会结束当前导航并清除旧路线。演示与真实数据不会混用。

导航网关根地址

高德 Key 留在网关，不填到这里。测试本地网关时可用 http://127.0.0.1:8787/。

保存并测试网关

网关状态未配置

请求浏览器真实定位

真实模式需要定位权限和精确位置。网页只用于前台调试；锁屏持续导航请使用安卓 APK。

红米手机打开方式

1. 使用 Chrome 浏览器；先用演示模式检查界面。
2. BLE 和定位需要安全来源：可信 HTTPS，或通过 USB 调试转发后的 localhost。普通局域网 HTTP 适合界面预览。
3. 真实网关还需允许当前页面来源的 CORS 请求；网页 HTTPS 与网关 HTTPS 保持一致。
4. 屏幕固件、蓝牙权限、定位权限都准备好后，在设备页连接。

### 调试控制台

左侧是手机操作流程。这里查看大屏预览、播放测试路线，以及定位与 BLE 的实际状态。

大屏预览 480 × 320 / 浏览器绘制

允许把模拟导航发到真实屏幕（显示 DEMO）

演示回放 0%

暂停 / 继续前进 100 米模拟定位丢失重置演示

路线进度0 m

播放倍速4 ×

连接与数据 查看快照

MODEDEMO

LOCATIONSIMULATED

BLE SESSIONDISCONNECTED

TX / RX FRAMES0 / 0

最近事件 · 不记录 Key 和真实坐标清空

调试边界与来源

这是可交互 HTML 调试工具，不能替代安卓 App 的锁屏、通知和后台服务测试。真实蓝牙未连接时，大屏区域只是浏览器预览。

真实路线使用自建网关的高德驾车接口，尚未适配电动车骑行规则。演示路线及附近道路来自原项目的公开济南 OSM 测试夹具。

协议与导航行为参考 Maler X / moto-gps-waveshare (https://github.com/mx3353672833-debug/moto-gps-waveshare)；原项目资料按 PolyForm Noncommercial 1.0.0 使用。地图数据 © OpenStreetMap contributors，ODbL。

不用 GPS 模块。手机负责位置、搜索和路线；ESP32 通过 BLE 接收显示数据。
单文件，无外部字体、脚本或分析统计。

### 当前显示快照

包含当前定位与路线状态，仅在本地展示。分享前删除真实位置。

关闭
