1wf3/esp32-s3/output/previews/web_debug/phone-preview.png

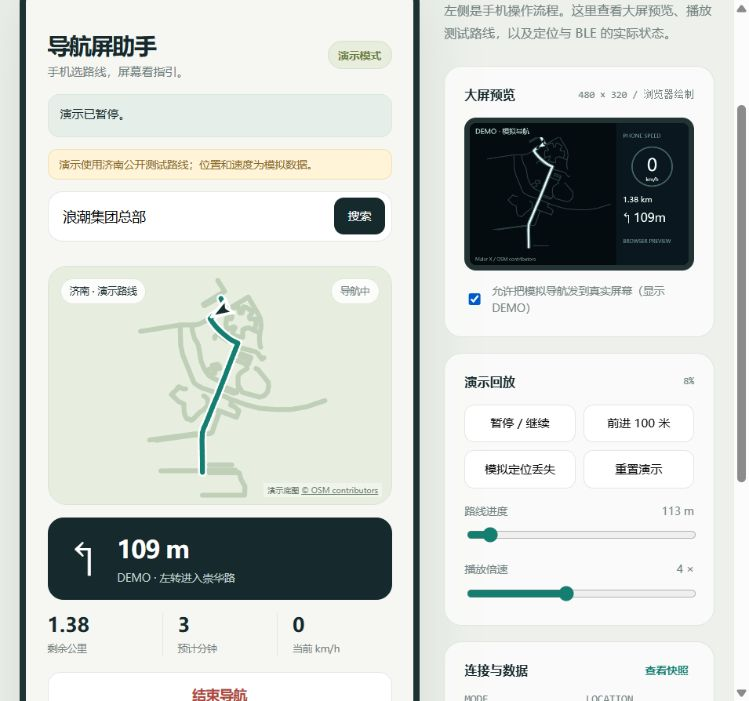
output/previews/web_debug/phone-preview.png
