1wf3/esp32-s3/output/previews/电脑HTML同步调试界面.png

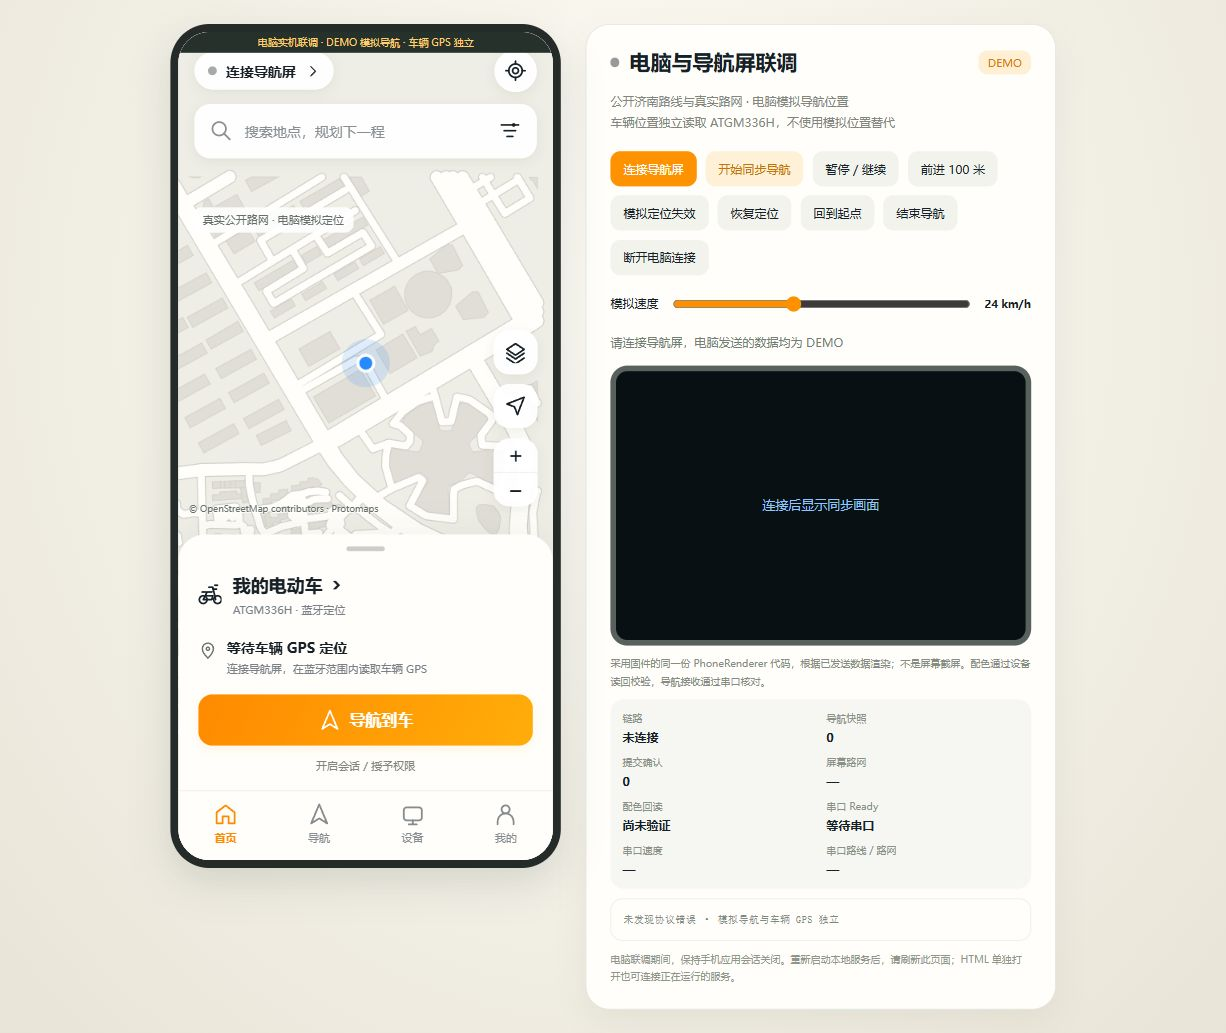
output/previews/电脑HTML同步调试界面.png
