1wf3/esp32-s3/software/wide_screen_nav/amap_root_ca.h

#pragma once
static const char AMAP_ROOT_CA[] = R"PEM(
-----BEGIN CERTIFICATE-----
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
HMUfpIBvFSDJ3gyICh3WZlXi/EjJKSZp4A==
-----END CERTIFICATE-----
)PEM";
